mat0imaru/thrust-torque-meter/cad/힘-토크 측정기기_v2.png

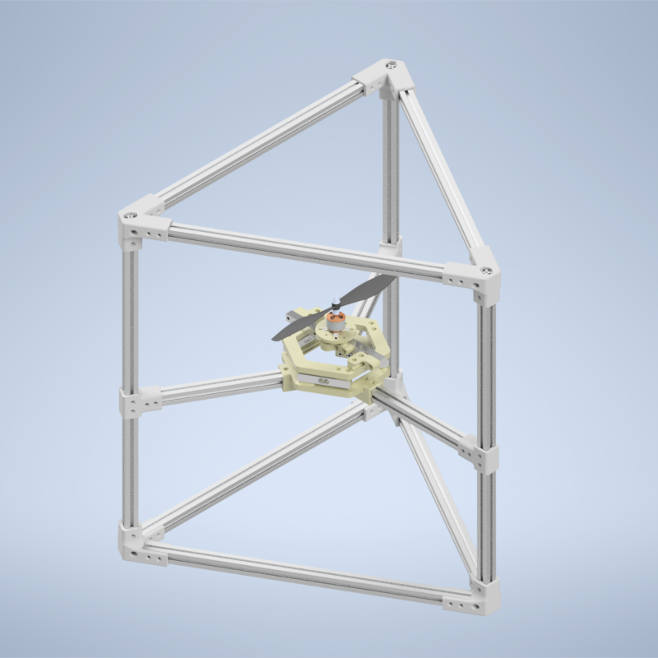
cad/힘-토크 측정기기_v2.png
