mat0imaru/thrust-torque-meter/README.md

# thrust-torque-meter
추력과 반토크를 측정하기 위한 계측기의 데이터를 담고 있는 repository입니다.
