mat0imaru/thrust-torque-meter/cad/bldc_sample/BLDC motor/BLDC and prop.JPG

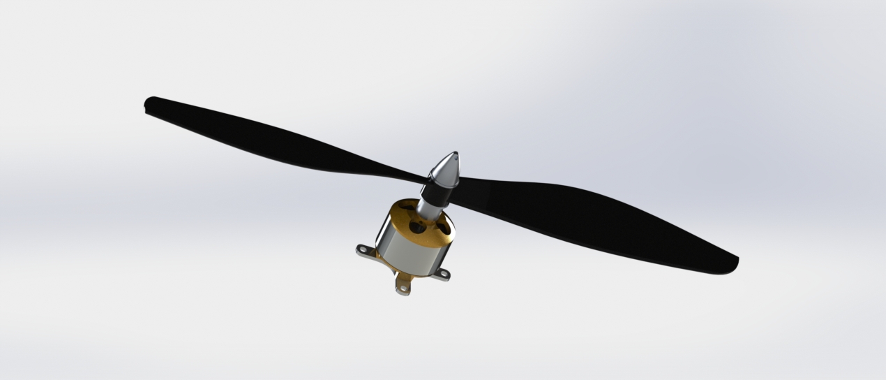
cad/bldc_sample/BLDC motor/BLDC and prop.JPG
