mat0imaru/thrust-torque-meter/cad/bldc_sample/BLDC motor/motor2.JPG

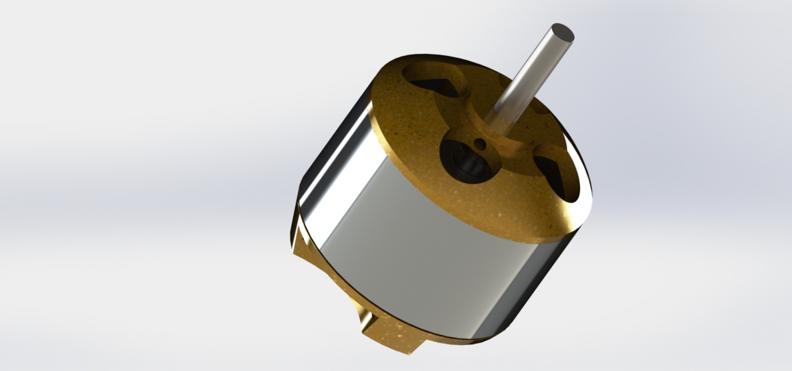
cad/bldc_sample/BLDC motor/motor2.JPG
