mat0imaru/thrust-torque-meter/cad/bldc_sample/BLDC motor/motor_stator.SLDASM

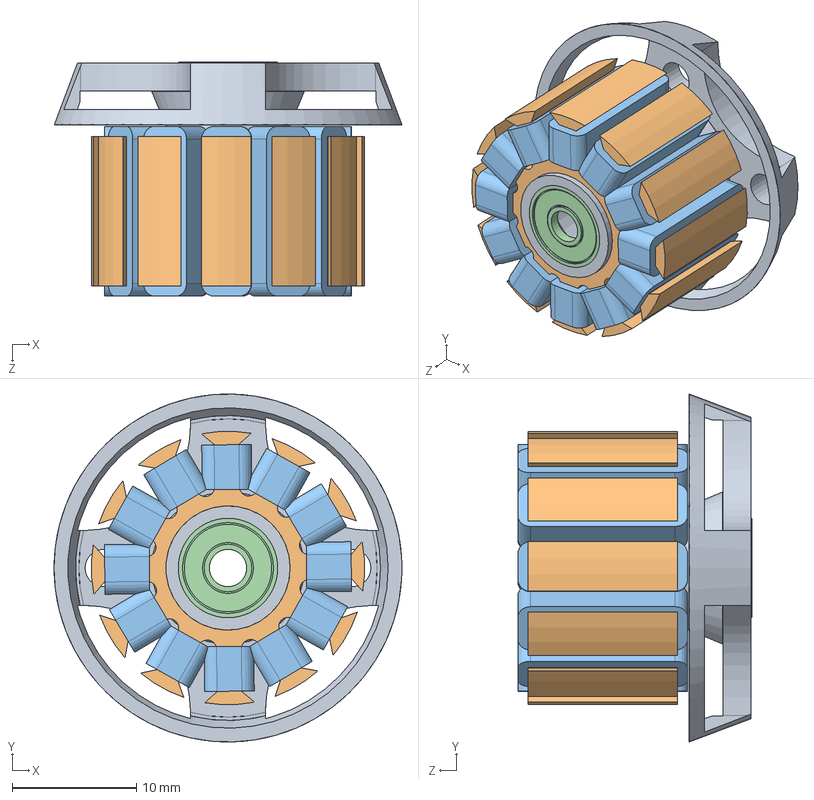
[picture p8: CAD file, 2021-04-15]
cad/bldc_sample/BLDC motor/motor_stator.SLDASM
28.0 x 28.0 x 18.8 mm
base
armature
wire x 12
bearing x 2
