mat0imaru/thrust-torque-meter/cad/bldc_sample/BLDC motor/motor_rotor.SLDASM

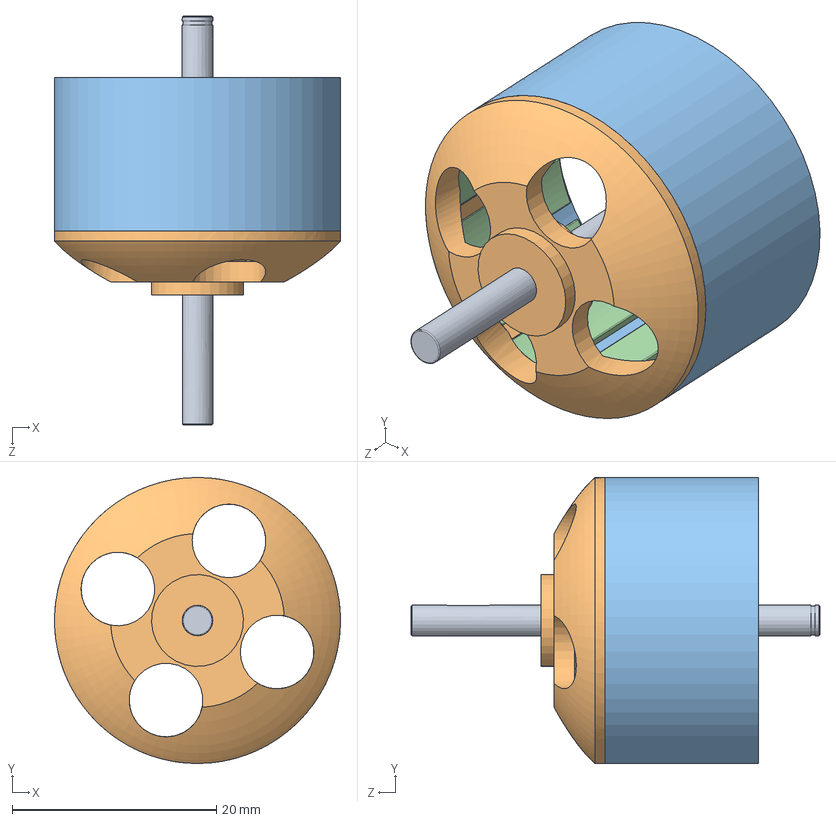
[picture p9: CAD file, 2021-04-15]
cad/bldc_sample/BLDC motor/motor_rotor.SLDASM
28.0 x 28.0 x 40.0 mm
shaft
rotor_part
ring
magnet x 14
