mat0imaru/thrust-torque-meter/cad/bldc_sample/BLDC motor/BLDC motor.SLDASM

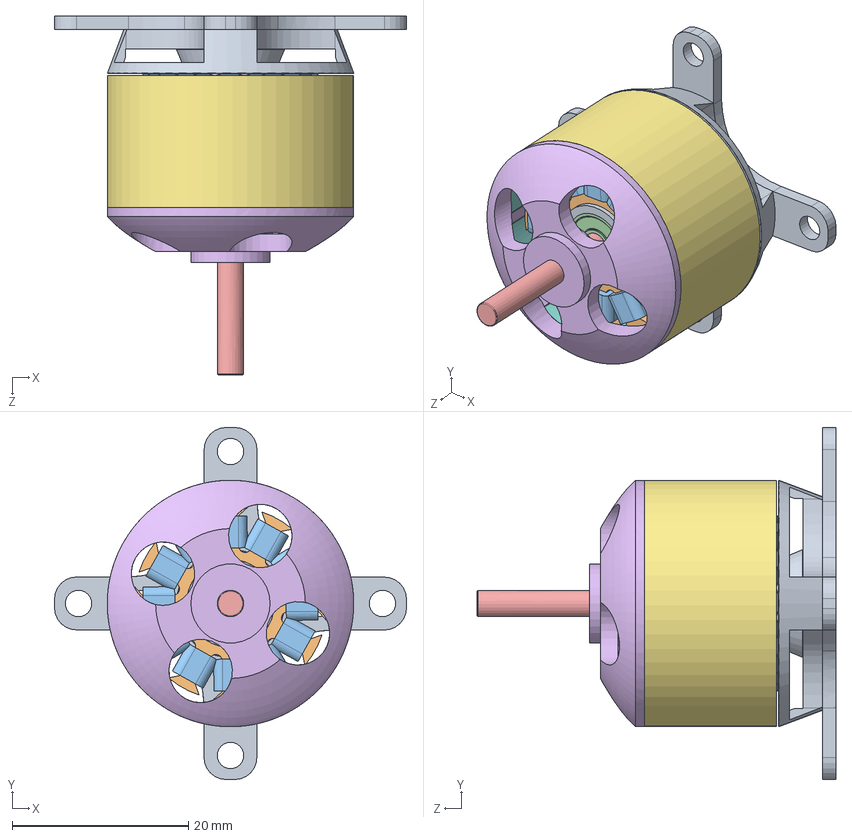
[picture p10: CAD file, 2021-04-15]
cad/bldc_sample/BLDC motor/BLDC motor.SLDASM
40.0 x 40.0 x 40.7 mm
base
armature
wire x 12
bearing x 2
shaft
rotor_part
ring
magnet x 14
clamp
