mat0imaru/thrust-torque-meter/cad/bldc_sample/BLDC motor/mot_prop.SLDASM

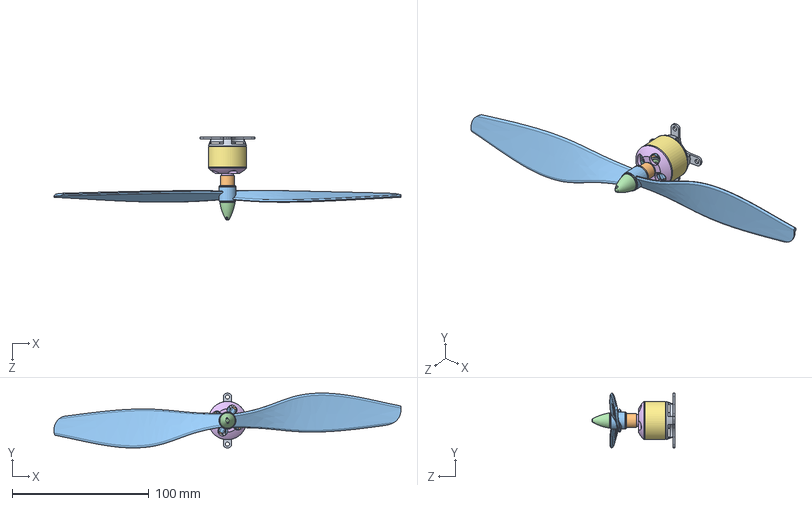
[picture p11: CAD file, 2021-04-15]
cad/bldc_sample/BLDC motor/mot_prop.SLDASM
253.7 x 40.2 x 60.6 mm
base
armature
wire x 12
bearing x 2
shaft
rotor_part
ring
magnet x 14
clamp
prop adapter
propeller
adapter nut
