mat0imaru/thrust-torque-meter/cad/bldc_sample/BLDC motor/clamp.SLDPRT

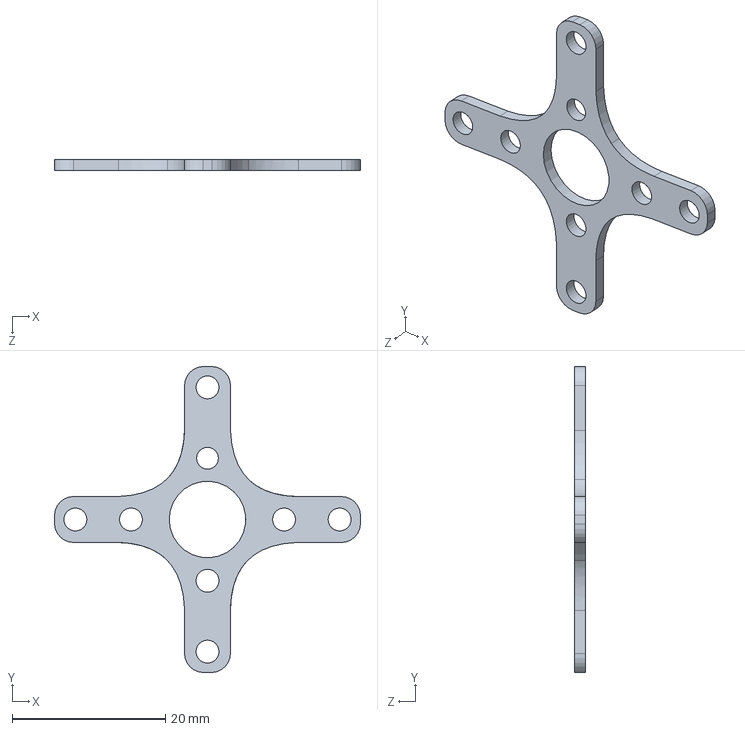
[picture p12: CAD file, 2021-04-15]
cad/bldc_sample/BLDC motor/clamp.SLDPRT
40.0 x 40.0 x 1.50 mm
