mat0imaru/thrust-torque-meter/cad/bldc_sample/BLDC motor/propeller.SLDPRT

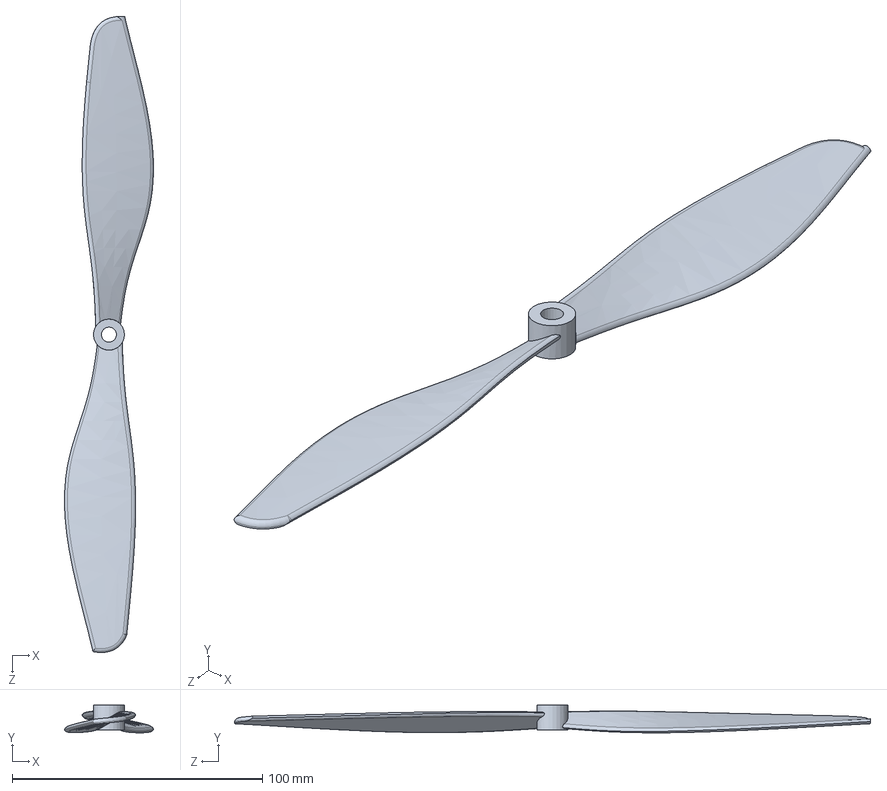
[picture p13: CAD file, 2021-04-15]
cad/bldc_sample/BLDC motor/propeller.SLDPRT
35.6 x 11.1 x 254.0 mm
