mat0imaru/thrust-torque-meter/cad/bldc_sample/BLDC motor/magnet.SLDPRT

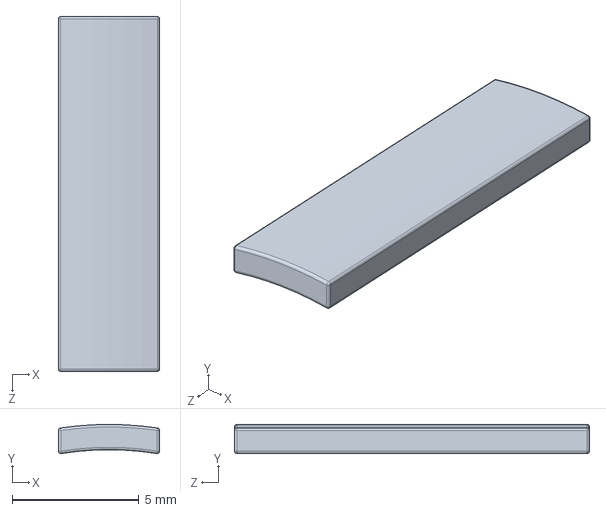
[picture p14: CAD file, 2021-04-15]
cad/bldc_sample/BLDC motor/magnet.SLDPRT
4.00 x 1.15 x 14.0 mm
