mat0imaru/thrust-torque-meter/cad/bldc_sample/BLDC motor/rotor_part.SLDPRT

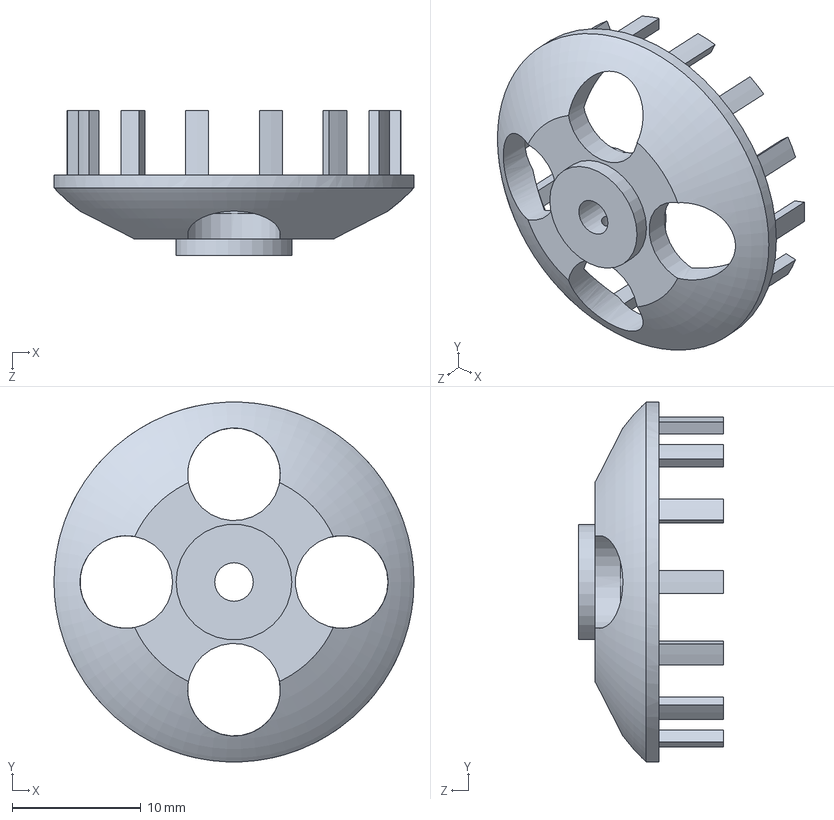
[picture p15: CAD file, 2021-04-15]
cad/bldc_sample/BLDC motor/rotor_part.SLDPRT
28.0 x 28.0 x 11.2 mm
