mat0imaru/thrust-torque-meter/cad/bldc_sample/BLDC motor/bearing.SLDPRT

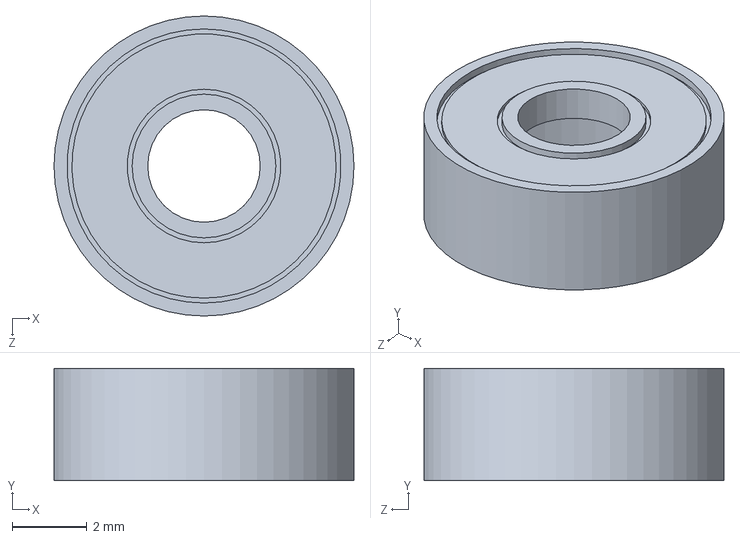
[picture p16: CAD file, 2021-04-15]
cad/bldc_sample/BLDC motor/bearing.SLDPRT
8.00 x 3.00 x 8.00 mm
