mat0imaru/thrust-torque-meter/cad/bldc_sample/BLDC motor/base.SLDPRT

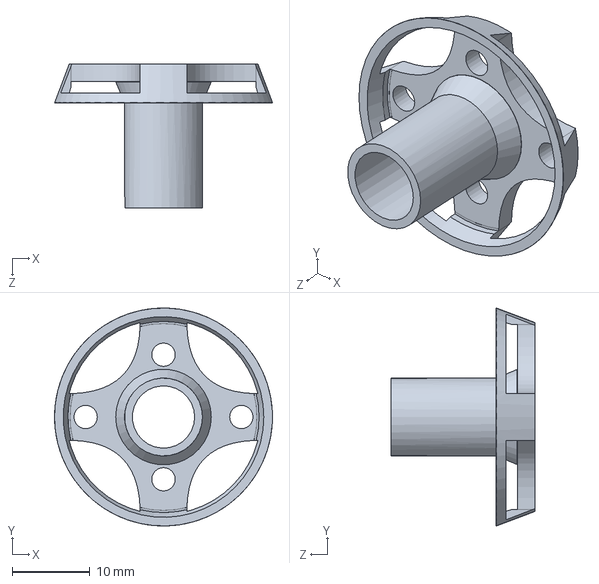
[picture p17: CAD file, 2021-04-15]
cad/bldc_sample/BLDC motor/base.SLDPRT
28.0 x 28.0 x 18.5 mm
