mat0imaru/thrust-torque-meter/cad/bldc_sample/BLDC motor/prop adapter.SLDPRT

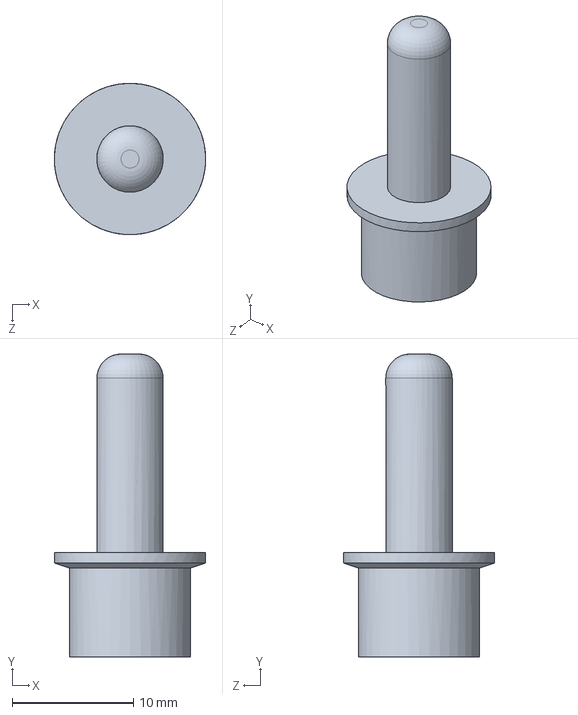
[picture p18: CAD file, 2021-04-15]
cad/bldc_sample/BLDC motor/prop adapter.SLDPRT
12.5 x 25.0 x 12.5 mm
