mat0imaru/thrust-torque-meter/cad/bldc_sample/BLDC motor/shaft.SLDPRT

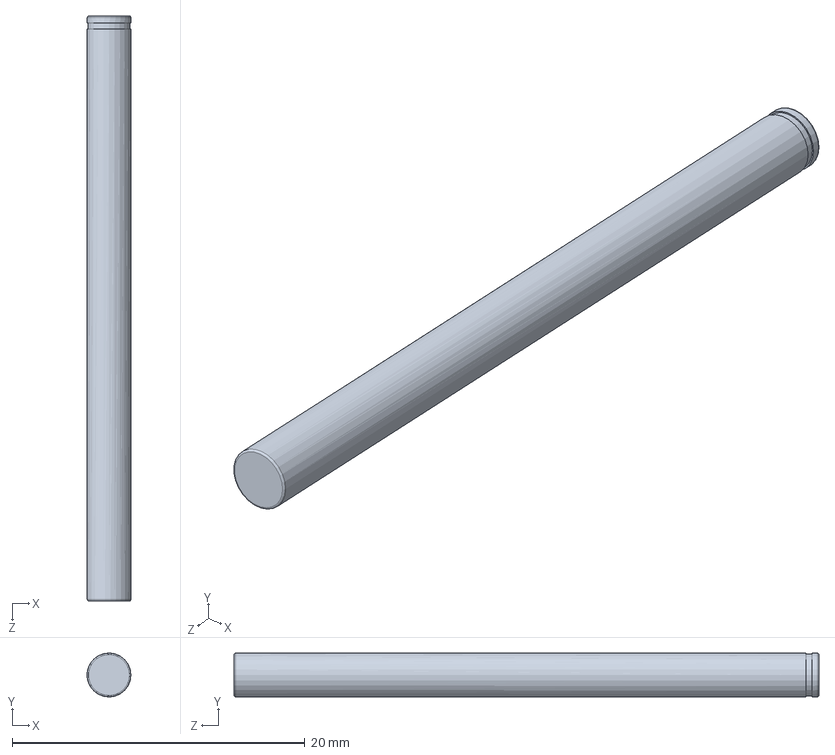
[picture p19: CAD file, 2021-04-15]
cad/bldc_sample/BLDC motor/shaft.SLDPRT
3.00 x 3.00 x 40.0 mm
