mat0imaru/thrust-torque-meter/cad/bldc_sample/BLDC motor/ring.SLDPRT

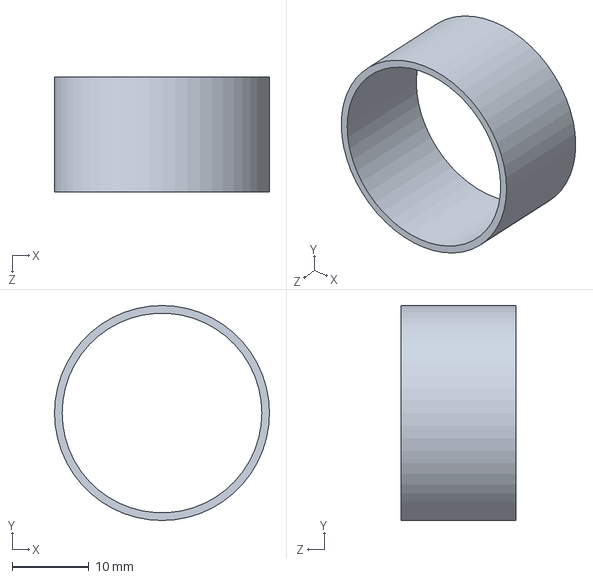
[picture p20: CAD file, 2021-04-15]
cad/bldc_sample/BLDC motor/ring.SLDPRT
28.0 x 28.0 x 15.0 mm
