mat0imaru/thrust-torque-meter/cad/bldc_sample/BLDC motor/armature.SLDPRT

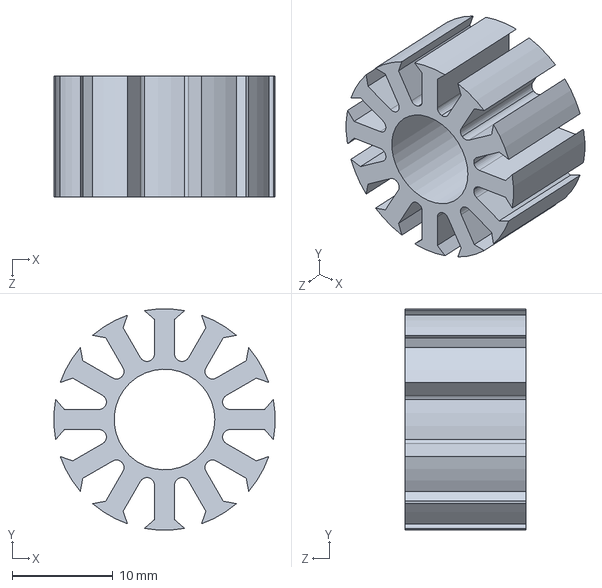
[picture p21: CAD file, 2021-04-15]
cad/bldc_sample/BLDC motor/armature.SLDPRT
22.0 x 22.0 x 12.0 mm
