mat0imaru/thrust-torque-meter/cad/bldc_sample/BLDC motor/wire.SLDPRT

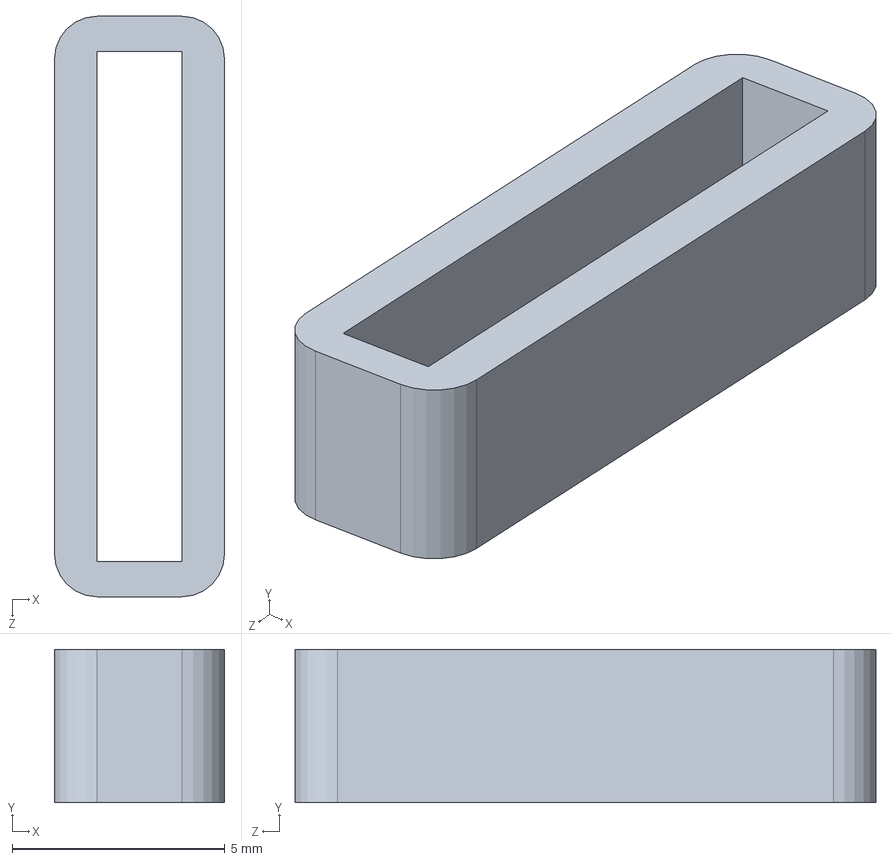
[picture p22: CAD file, 2021-04-15]
cad/bldc_sample/BLDC motor/wire.SLDPRT
4.00 x 3.60 x 13.7 mm
