mat0imaru/thrust-torque-meter/cad/bldc_sample/BLDC motor/adapter nut.SLDPRT

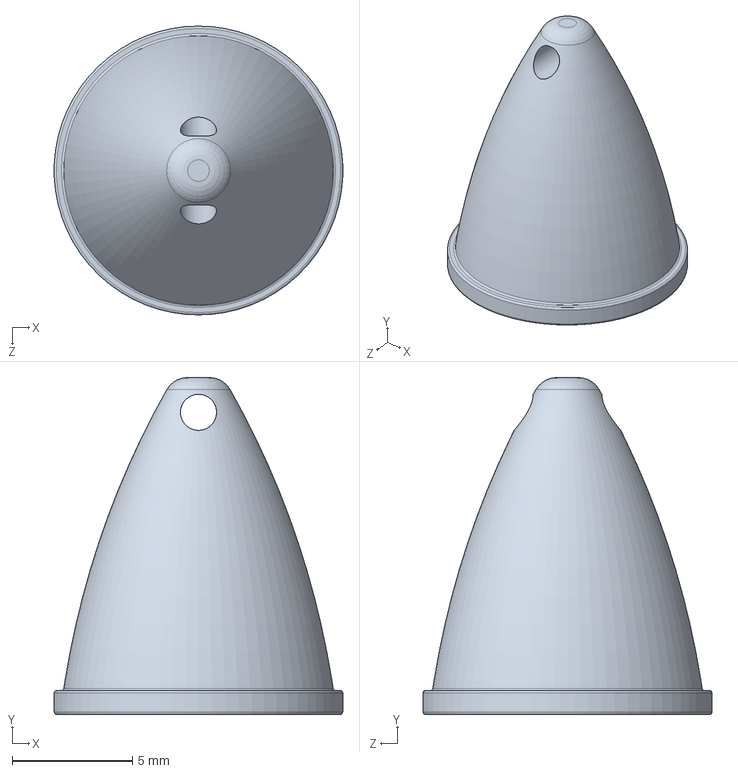
[picture p23: CAD file, 2021-04-15]
cad/bldc_sample/BLDC motor/adapter nut.SLDPRT
12.0 x 14.0 x 12.0 mm
