mat0imaru/thrust-torque-meter/(list of files, cad)

Other CAD files:
cad/df_2020.dwg
cad/300mm 2020.ipt
cad/500mm 2020.ipt
cad/600mm 2020.ipt
cad/[한진데이타]_4선식_저가형_로드셀_5Kg.ipt
cad/base_v2.ipt
cad/bldc_sample/BLDC motor/BLDC motor.iam
cad/bldc_sample/BLDC motor/OldVersions/BLDC motor.0001.iam
cad/bldc_sample/BLDC motor/OldVersions/BLDC motor.0002.iam
cad/bldc_sample/BLDC motor/adapter nut.ipt
cad/bldc_sample/BLDC motor/armature.ipt
cad/bldc_sample/BLDC motor/base.ipt
cad/bldc_sample/BLDC motor/bearing.ipt
cad/bldc_sample/BLDC motor/clamp.ipt
cad/bldc_sample/BLDC motor/magnet.ipt
cad/bldc_sample/BLDC motor/motor_rotor.iam
cad/bldc_sample/BLDC motor/motor_stator.iam
cad/bldc_sample/BLDC motor/prop adapter.ipt
cad/bldc_sample/BLDC motor/propeller.ipt
cad/bldc_sample/BLDC motor/ring.ipt
cad/bldc_sample/BLDC motor/rotor_part.ipt
cad/bldc_sample/BLDC motor/shaft.ipt
cad/bldc_sample/BLDC motor/wire.ipt
cad/case_corner.ipt
cad/connector_v2.ipt
cad/motor_mount.ipt
cad/motor_mount_v2.ipt
cad/profile_bracket.ipt
cad/pully_holder.ipt
cad/right_angle_profile_mount.ipt
cad/torque_base.ipt
cad/torque_calibrator.ipt
cad/힘-토크 측정기기_v2.iam
